AbramiakA/FPV/VTX_Holder.stl

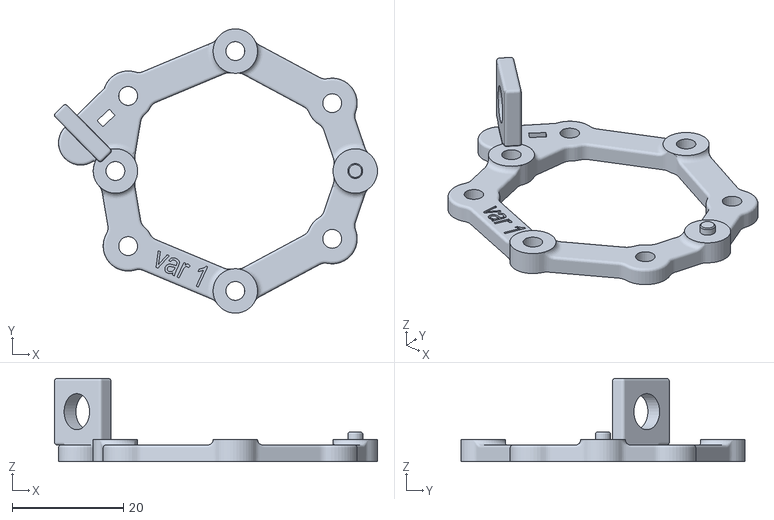
[picture p20: CAD file, 2026-09-25]
VTX_Holder.stl
58.1 x 51.1 x 15.0
