AbramiakA/FPV/(list of files, cad)

Other CAD files:
VTX_Holder.f3d
VTX_Mount_Assembly.f3z
